lampertb/LampertCircuitRNG/Hardware/RNG_Board.brd

## EAGLE design Hardware/RNG_Board.brd (2019-09-23)

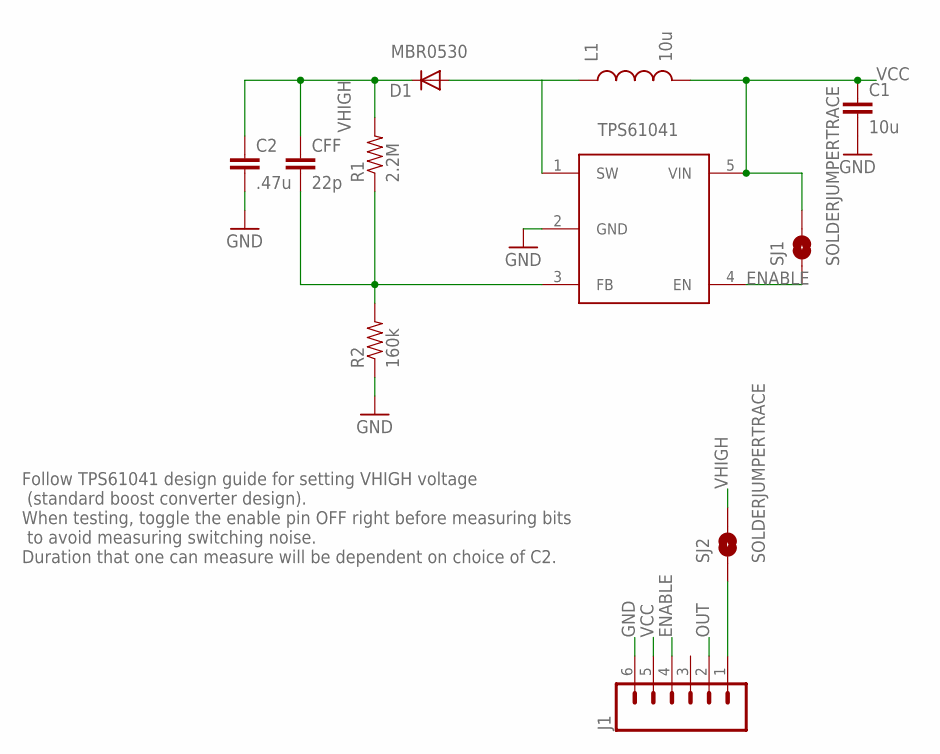
[picture p1: schematic RNG_Board.sch, sheet 1]

Parts:
C1: 10u; 0603-CAP
C2: .47u; 0603-CAP
CFF: 22p; 0603-CAP
D1: MBR0530; SOD-123_MINI-SMA
J1: M06SILK_FEMALE_PTH; 1X06
L1: 10u; 0805
R1: 2.2M; 0603-RES
R2: 160k; 0603-RES
SJ1, SJ2: SOLDERJUMPERTRACE; SJ_2S-TRACE
U$1: TPS61040; SOT23-5

Connections:
ENABLE: J1.4, SJ1.1, U$1.4 (EN)
GND: C1.2, C2.2, J1.6, R2.1, U$1.2 (GND); also elsewhere on the board
unnamed: CFF.2, R1.1, R2.2, U$1.3 (FB)
unnamed: D1.A, L1.1, U$1.1 (SW)
unnamed: J1.1, SJ2.1
OUT: J1.2; also elsewhere on the board
VCC: C1.1, J1.5, L1.2, SJ1.2, U$1.5 (VIN); also elsewhere on the board
VHIGH: C2.1, CFF.1, D1.C, R1.2, SJ2.2; also elsewhere on the board

Notes on the sheet:
TPS61041
Follow TPS61041 design guide for setting VHIGH voltage (standard boost converter design). When testing, toggle the enable pin OFF right before measuring bits to avoid measuring switching noise. Duration that one can measure will be dependent on choice of C2.

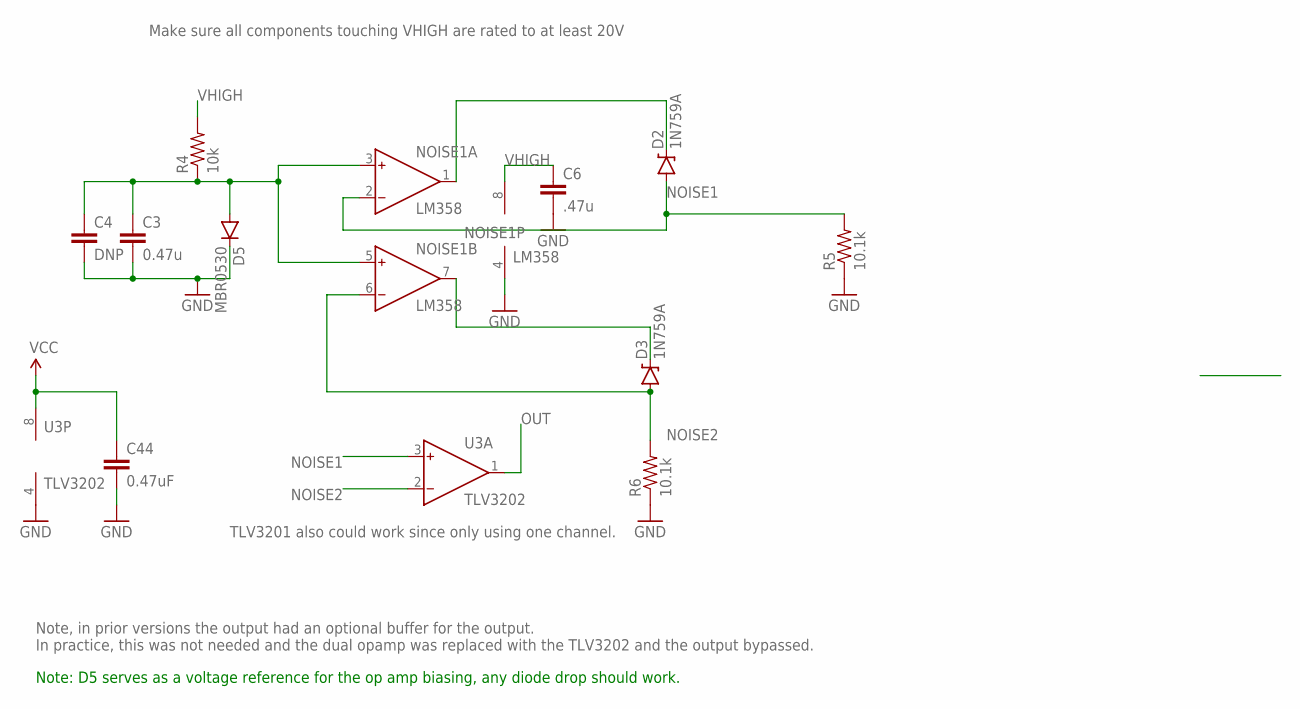
[picture p2: schematic RNG_Board.sch, sheet 2]

Parts:
C3: 0.47u; 0603-CAP
C4: DNP; 0603-CAP
C6: .47u; 0603-CAP
C44: 0.47uF; C0603
D2, D3: 1N759A; DIODE-ZENER; MPN 610-1N759A
D5: MBR0530; SOD-123
NOISE1: LM358; SO8
R4: 10k; 0603-RES
R5, R6: 10.1k; 0603-RES
U3: TLV3202; SO8

Connections:
GND: C3.2, C4.2, C6.2, C44.2, D5.C, NOISE1.4 (V-), R5.1, R6.1, U3.4 (V-); also elsewhere on the board
unnamed: D2.P$1 (C), NOISE1.1 (OUT)
unnamed: D3.P$1 (C), NOISE1.7 (OUT)
unnamed: C3.1, C4.1, D5.A, NOISE1.3 (IN+), NOISE1.5 (IN+), R4.1
NOISE1: D2.P$2 (A), NOISE1.2 (IN-), R5.2, U3.3 (IN+)
NOISE2: D3.P$2 (A), NOISE1.6 (IN-), R6.2, U3.2 (IN-)
OUT: U3.1 (OUT); also elsewhere on the board
VCC: C44.1, U3.8 (V+); also elsewhere on the board
VHIGH: C6.1, NOISE1.8 (V+), R4.2; also elsewhere on the board

Notes on the sheet:
Make sure all components touching VHIGH are rated to at least 20V
Note, in prior versions the output had an optional buffer for the output. In practice, this was not needed and the dual opamp was replaced with the TLV3202 and the output bypassed.
TLV3201 also could work since only using one channel.
Note: D5 serves as a voltage reference for the op amp biasing, any diode drop should work.

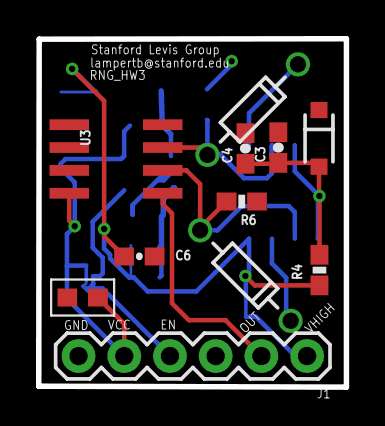
[picture p3: board RNG_Board.brd from above]

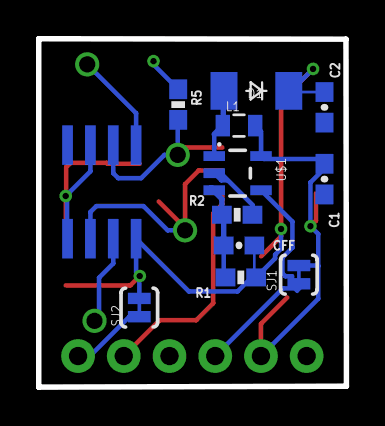
[picture p4: board RNG_Board.brd from below]

Board: 2 copper layers, 17.1 x 19.4 mm, 23 parts (12 on the bottom side), 13 nets.
