lampertb/LampertCircuitRNG/Hardware/RNG_FinalBoard.brd

## EAGLE design Hardware/RNG_FinalBoard.brd (2016-09-06)

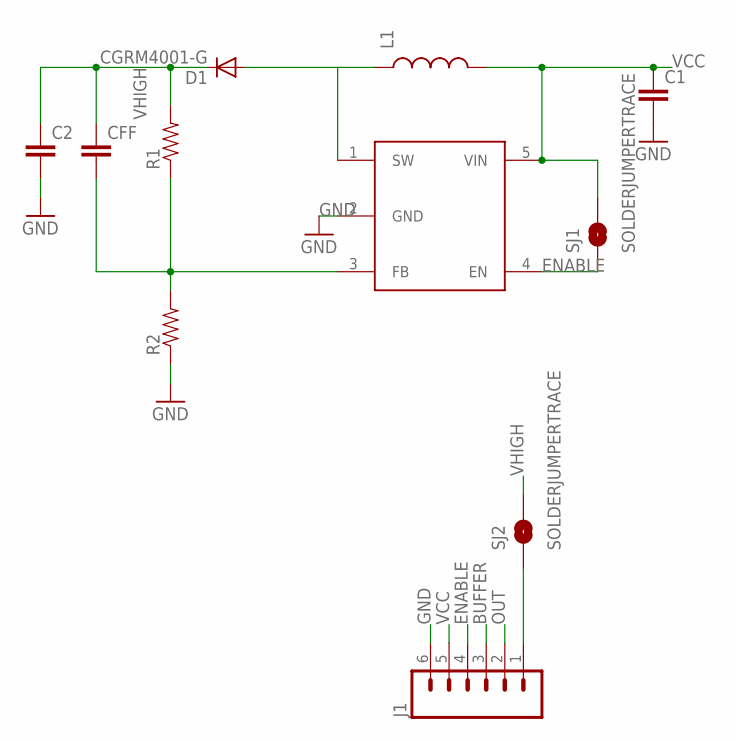
[picture p5: schematic RNG_FinalBoard.sch, sheet 1]

Parts:
C1, C2: CAP0603-CAP; 0603-CAP
CFF: CAP0603-CAP; 0603-CAP
D1: CGRM4001-G; SOD-123_MINI-SMA
J1: M06SILK_FEMALE_PTH; 1X06
L1: INDUCTOR0805; 0805
R1, R2: 0.27OHM-1/10W-1%(0603); 0603-RES
SJ1, SJ2: SOLDERJUMPERTRACE; SJ_2S-TRACE
U$1: TPS61040; SOT23-5

Connections:
BUFFER: J1.3; also elsewhere on the board
ENABLE: J1.4, SJ1.1, U$1.4 (EN)
GND: C1.2, J1.6, R2.1, U$1.2 (GND); also elsewhere on the board
unnamed: CFF.2, R1.1, R2.2, U$1.3 (FB)
unnamed: D1.A, L1.1, U$1.1 (SW)
unnamed: J1.1, SJ2.1
OUT: J1.2; also elsewhere on the board
VCC: C1.1, J1.5, L1.2, SJ1.2, U$1.5 (VIN); also elsewhere on the board
VHIGH: C2.1, CFF.1, D1.C, R1.2, SJ2.2; also elsewhere on the board

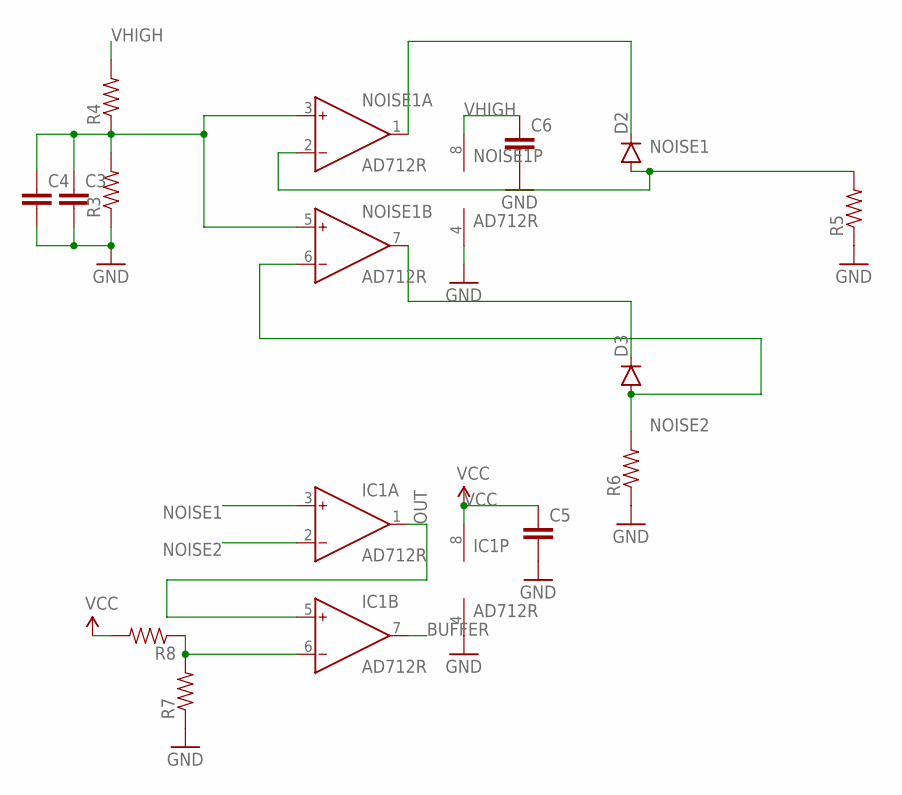
[picture p6: schematic RNG_FinalBoard.sch, sheet 2]

Parts:
C3, C4, C5, C6: CAP0603-CAP; 0603-CAP
D2, D3: DIODESOD523; SOD523
IC1: AD712R; SO8
NOISE1: AD712R; SO8
R3, R4, R5, R6: RESISTOR0603; 0603-RES
R7, R8: RESISTOR0603-RES; 0603-RES

Connections:
BUFFER: IC1.7 (OUT); also elsewhere on the board
GND: C3.2, C4.2, C5.2, C6.2, IC1.4 (V-), NOISE1.4 (V-), R3.1, R5.1, R6.1, R7.1; also elsewhere on the board
unnamed: D2.C, NOISE1.1 (OUT)
unnamed: D3.C, NOISE1.7 (OUT)
unnamed: IC1.6 (IN-), R7.2, R8.1
unnamed: C3.1, C4.1, NOISE1.3 (IN+), NOISE1.5 (IN+), R3.2, R4.1
NOISE1: D2.A, IC1.3 (IN+), NOISE1.2 (IN-), R5.2
NOISE2: D3.A, IC1.2 (IN-), NOISE1.6 (IN-), R6.2
OUT: IC1.1 (OUT), IC1.5 (IN+); also elsewhere on the board
VCC: C5.1, IC1.8 (V+), R8.2; also elsewhere on the board
VHIGH: C6.1, NOISE1.8 (V+), R4.2; also elsewhere on the board

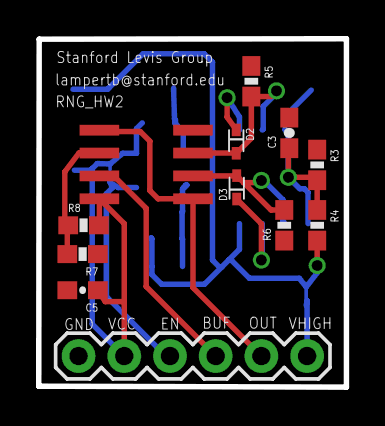
[picture p7: board RNG_FinalBoard.brd from above]

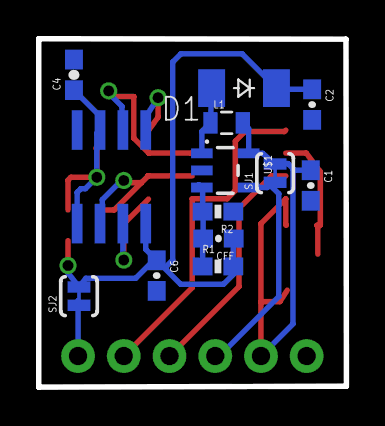
[picture p8: board RNG_FinalBoard.brd from below]

Board: 2 copper layers, 17.1 x 19.4 mm, 25 parts (13 on the bottom side), 15 nets.
