lampertb/LampertCircuitRNG/(threads)

Thread 1 (2018-09-13):

Cannot find component values in schematics

Matshakan, 2018-09-13:
When loading the Eagle schematics file I cannot find any component values.
I'm quite new to using Eagle so maybe I missed something.
