lampertb/LampertCircuitRNG/(commit log)

2016-09-06 Added hardware eagle files
    [RNG_FinalBoard.brd, RNG_FinalBoard.sch]
2019-09-23 Updated design to reflect imix design
    Updates:
    -Changed Zener diode to use 1N759A which is the diode used in the imix design
    -Added BOM file
    -Dropped buffer output (not needed in design)
    -Layout changes
    [RNG_Board.brd, RNG_Board.sch]
